m9aertner/StackMatGen4TimerTeensy/KiCAD/README.md

# KiCAD Schematic for StackMatGen4TimerTeensyLED

The Teensy-LC component is available at [https://github.com/XenGi/teensy_library](https://github.com/XenGi/teensy_library)

KiCAD files:
- [StackMatGen4TimerTeensyLED.pro](StackMatGen4TimerTeensyLED.pro)
- [StackMatGen4TimerTeensyLED.sch](StackMatGen4TimerTeensyLED.sch)
- [StackMatGen4TimerTeensyLED.svg](StackMatGen4TimerTeensyLED.svg)

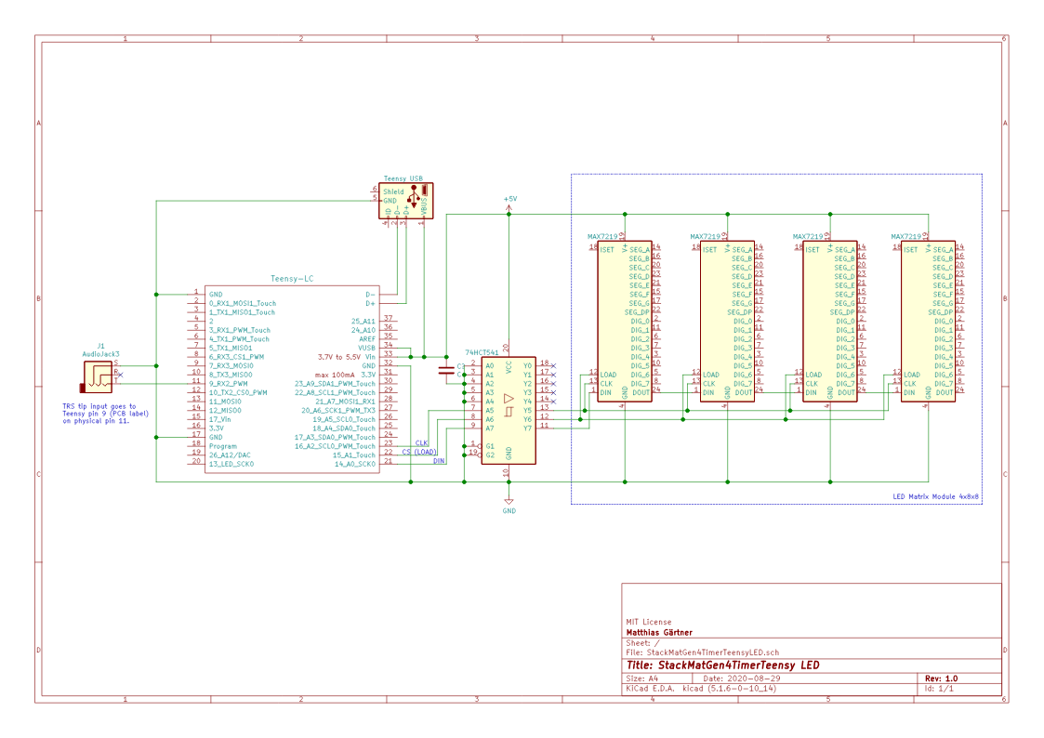
[picture p5: KiCAD/StackMatGen4TimerTeensyLED.png]
Schematic PNG
