m9aertner/StackMatGen4TimerTeensy/KiCAD/StackMatGen4TimerTeensyLED.sch

## KiCad design KiCAD/StackMatGen4TimerTeensyLED.sch (2020-08-28)

Schematic: StackMatGen4TimerTeensyLED.sch

Parts:
J1: AudioJack3
J2: Teensy USB
U1: 74HCT541
U2: Teensy-LC
U3: MAX7219

Notes on the sheet:
TRS tip input goes to Teensy pin 9 (PCB label) on physical pin 11.
CS (LOAD)
CLK
DIN
LED Matrix Module 4x8x8
