m9aertner/StackMatGen4TimerTeensy/images/DS1Z_QuickPrint2.png

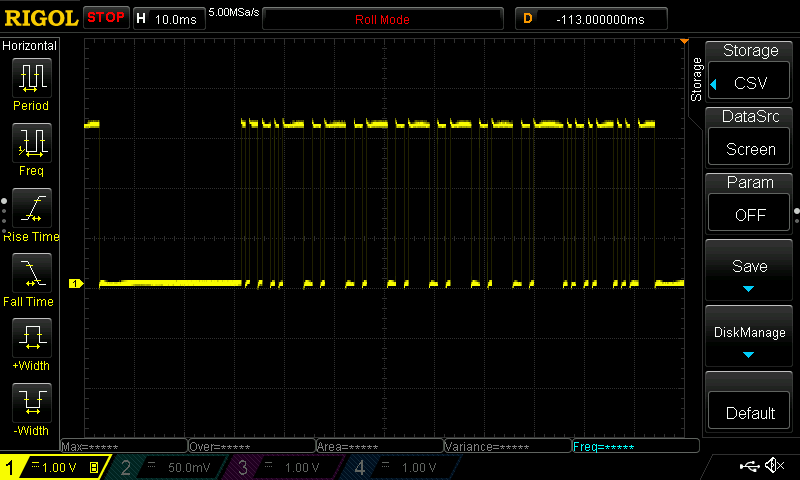
images/DS1Z_QuickPrint2.png
