m9aertner/StackMatGen4TimerTeensy/src/Teensy-StackMat-LED/TeensyStackMatFont.cpp

/**

  StackMatGen4TimerTeensy - Teensy LC StackMat Display - LED version

*/

/**

  MIT License

  Copyright (c) 2020 Matthias Gaertner https://github.com/m9aertner

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
*/

#include "TeensyStackMatFont.h"

/*
 * Encoding is 8 byte per character, only lower nibble used,
 * lower address represents lower row on the display,
 * least significant bit is rightmost bit on display.
 * Yes, with *my* display this needs a bit reversal step, but
 * I can't be bothered to re-code these (manually).
 */
const byte TeensyStackMatFont::DIGITS4[13 * 8] PROGMEM = {
    // 0
    B00000110,
    B00001001,
    B00001001,
    B00001001,
    B00001001,
    B00001001,
    B00001001,
    B00000110,
    // 1
    B00000010,
    B00000110,
    B00000010,
    B00000010,
    B00000010,
    B00000010,
    B00000010,
    B00000111,
    // 2
    B00000110,
    B00001001,
    B00000001,
    B00000010,
    B00000100,
    B00001000,
    B00001000,
    B00001111,
    // 3
    B00000110,
    B00001001,
    B00000001,
    B00000110,
    B00000001,
    B00000001,
    B00001001,
    B00000110,
    // 4
    B00001010,
    B00001010,
    B00001010,
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
    // :
    B00000000,
    B00000000,
    B00000010,
    B00000010,
    B00000000,
    B00000010,
    B00000010,
    B00000000,
    // .
    B00000000,
    B00000000,
    B00000000,
    B00000000,
    B00000000,
    B00000000,
    B00000000,
    B00000010,
    // Space
    B00000000,
    B00000000,
    B00000000,
    B00000000,
    B00000000,
    B00000000,
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
{
  const byte *font;
  if (sz == 2)
    font = ANIMATION;
  else if (sz == 1)
    font = DIGITS3;
  else
    font = DIGITS4;

  int n = 12;
  if (c >= '0' && c <= '9')
    n = c - '0';
  else if (c == ':')
    n = 10;
  else if (c == '.')
    n = 11;

  return font + n * 8;
}
