m9aertner/StackMatGen4TimerTeensy/(commit log)

2020-08-18 Inital content, Teensy-LC OLED
2020-08-28 Teensy-LC with LED Matrix 4x8x8 Schematics
    [StackMatGen4TimerTeensyLED.sch]
2020-08-29 Switching to VisualCode / VisualTeensy for development - please adjust the paths or re-create with VSTeensy!
2020-08-29 Teensy-LC LED
    Display StackMat G4 time on 32x8 LED matrix display
    Customized version of LedControl LED matrix driver, support for smaller-width digits
    so that 0:00:000 fits into 32x8 LED.
    Using smaller font for sub-second digits makes for nicer-looking display.
    "TRS Wire" animation when no signal has been received for 15s.
2020-08-29 Teensy-LC LED visuals
